plaes/AppleII-VGA/(commit log)

2024-01-29 pcb-smd: Add various required footprints
2024-01-29 pcb-smd: Add new SMD-mod board + breakoff VGA board
    [AppleVGA.kicad_pcb, AppleVGA.kicad_sch, VGA_Connector.kicad_sch]
2024-01-29 pcb-smd: List changes and add manufacturing outputs.
    [AppleVGA-B_Cu.gbr, AppleVGA-B_Mask.gbr, AppleVGA-Edge_Cuts.gbr, AppleVGA-F_Cu.gbr, AppleVGA-F_Mask.gbr, AppleVGA-F_Paste.gbr, AppleVGA-F_Silkscreen.gbr, AppleVGA-NPTH.drl]
2024-02-09 Add JLCJLCJLC text for order placement text
    [AppleVGA-B_Cu.gbr, AppleVGA-B_Mask.gbr, AppleVGA-Edge_Cuts.gbr, AppleVGA-F_Cu.gbr, AppleVGA-F_Mask.gbr, AppleVGA-F_Paste.gbr, AppleVGA-F_Silkscreen.gbr, AppleVGA-NPTH.drl]
