plaes/AppleII-VGA/(notices)

Notices in the files:
AppleVGA/AppleVGA.kicad_pcb:
Licensed under CERN-OHL-P V2.0 (https://ohwr.org/cern_ohl_p_v2.txt)
Copyright (c) 2021-2023 Mark Aikens
AppleVGA/AppleVGA.kicad_sch:
Copyright (c) 2024 Priit Laes
